sv1onw/Si5351_OLED_DFS_CW/si5351_amp_sm.jpg

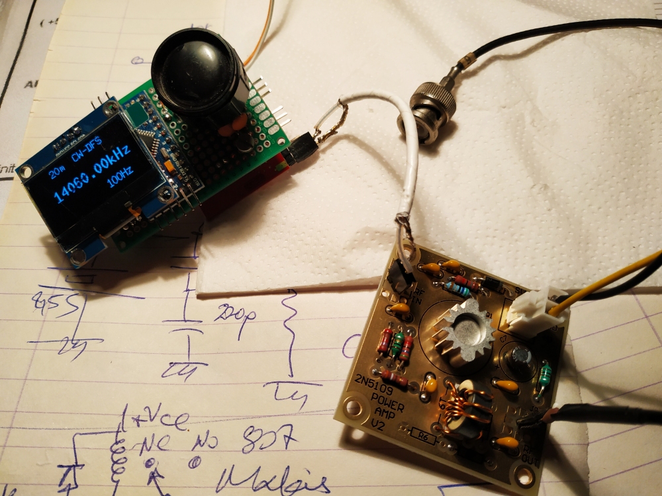
si5351_amp_sm.jpg
