sv1onw/Si5351_OLED_DFS_CW/2n5109 a1e22.png

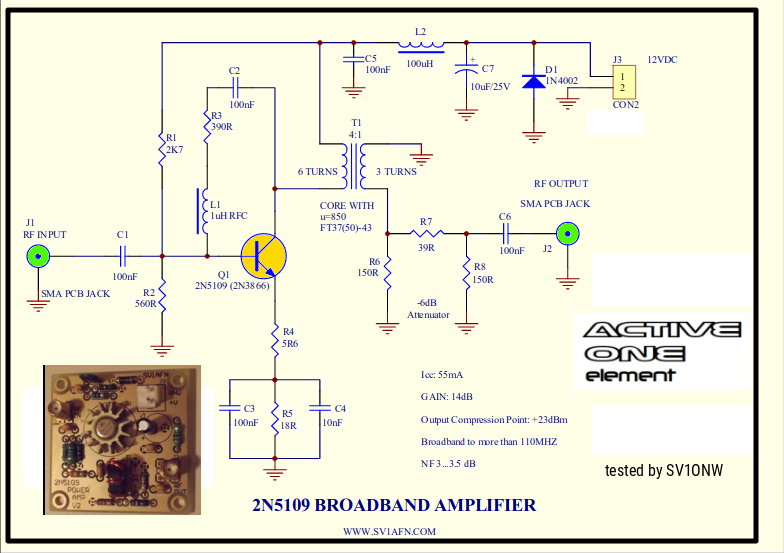
2n5109 a1e22.png
