sv1onw/Si5351_OLED_DFS_CW/20m lpf.png

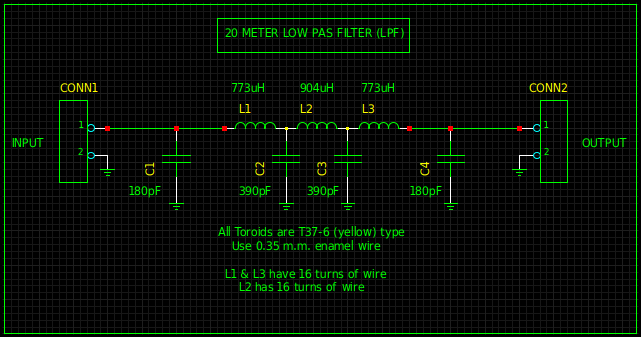
20m lpf.png
