sv1onw/Si5351_OLED_DFS_CW/CW KEYER1.JPG

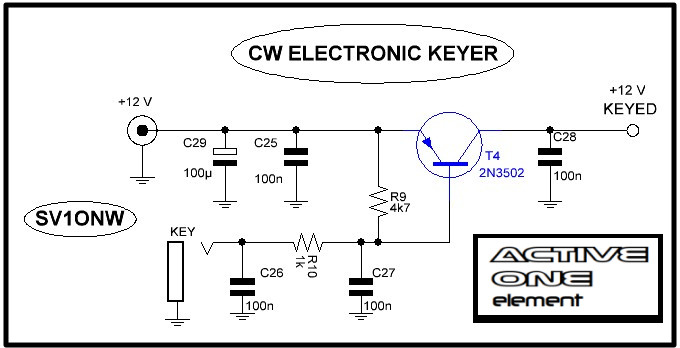
CW KEYER1.JPG
