sv1onw/Si5351_OLED_DFS_CW/CW_TX_20-DFS_v1.1.ino

// 20m CW_MONOBAND_TX  DFS  (Digital Frequency Synthesizer, aka PLL) 
// Initial PLL Code written by Antony Watts, M0IFA.
// Adaptation by SV1ONW to suit specific needs and incorporate Band frequency limits.
// 
// Band freq 14.000000 -14.10000 MHz = DFS frequency
// 
// CLK0 = L.O. DFS, CLK2 = Calibration Test Frequency 8.000000 MHz OPTION
  
#include "Oled.h"                                          // include header with predefined functions for U8g2 library (Library must be installed!)
#include <si5351.h>                                        // include library
#include "Rotary.h"                                        // include library

#define DT 2                                               // encoder connnections
#define CLK 3                                              // reverse pins 2 & 3 if wrong direction on rotary encoder!
#define SW 5                                               // the Digital pin where the Rotary Encoder's push button switch is connected
//
// Frequencies are written as xxYYYYYY00, where xx= Megacycles, YYYYYY= rest of frequency followed by two zeros. e,g, 3.2768 is written 327680000
#define CALIBRATION -4863                                  // frequency CALIBRATION, can be + or - , in my module is -57.63 Hz. Put your value here!

#define FREQMIN   1400000000                               // tune range 14.0-14.100 MHz , down limit
#define FREQMAX   1410000000                               // upper limit of 20 meter Band
//
//

Si5351 dfs;                                                // create dfs object
Rotary enc = Rotary(CLK, DT);                              // create encoder object

uint64_t freq = 1406000000;                                // initial frequency cHz, where DFS starts when powered on!
uint64_t freqStep = 10000;                                 // initial step cHz (100Hz), when powered on
uint64_t testFreq = 800000000;                             // test Frequency = 8.000000 MHz for Calibration purposes 

//

void setup() {
  pinMode(CLK, INPUT_PULLUP);                              // encoder input, with pull-up
  pinMode(DT, INPUT_PULLUP);                               // encoder input, with pull-up
  pinMode(SW, INPUT_PULLUP);                               // button  input, with pull-up

  oled.begin();                                            // begin OLED display

  dfs.init(SI5351_CRYSTAL_LOAD_8PF, 27000000, CALIBRATION);// set xtal capacitance, CRYSTAL FREQUENCY = 27MHz. CALIBRATION value is defined above.
                                                           // initial xtal frequency of 27MHz is defined in "si5351.h" header file! 
                                                           // crystal load is 8pF for SV1AFN's Si5351a board!
  dfs.drive_strength(SI5351_CLK0, SI5351_DRIVE_8MA);       // output drive 2 or 4 or 6 or 8ma. 8ma is aprox. +10dBm! 
//
  dfs.drive_strength(SI5351_CLK2, SI5351_DRIVE_2MA);       // output drive 2 or 4 or 6 or 8ma. 8ma is aprox. +10dBm!
// ONE OUTPUT ONLY plus Calibration optional

  dfs.output_enable(SI5351_CLK0, 1);                       // enable CLK0 
//
  dfs.output_enable(SI5351_CLK2, 1);                       // enable CLK2

  freqSet(freq , 0);                                       // output frequency CLK0, 14.060000 MHz 
//
//freqSet(testFreq, 2);                                    // output frequency CLK2, 8.000000 MHz Test Frequency for manual Calibration, you must enable it first (see below)!
  
//

  dispUpdate();                                            // display
}

// LOOP
void loop() {
//
  unsigned char result;                                    // encoder result

  if (digitalRead(SW) == LOW) {                            // enc button push
//
    while (!digitalRead(SW));                              // wait release
//
// 
//   
//     
//     
//     
//
    if (freqStep == 1000) freqStep = 1000000;              // update step i.e. 1000000 = 10kHz
    else freqStep = freqStep / 10;                         // step down
    dispUpdate();                                          // display
  }

  result = enc.process();                                  // read encoder
  if (result == DIR_CW)  {                                 // freq up
    freq += freqStep;
    if (freq >=FREQMAX)  {                                 // check the upper limit 14.100 MHz
        freq  =FREQMAX;
    }  
    freqSet(freq, 0);                                      // update CLK0/freq 
    dispUpdate();
  }
  if (result == DIR_CCW) {                                 // freq down
    freq -= freqStep;
    if (freq <=FREQMIN)  {                                 // check the lower limit 14.000 MHz
        freq  =FREQMIN;
    }  
    freqSet(freq, 0);                                      // update CLK0/freq
    dispUpdate();
  }
}

void freqSet(uint64_t f, byte n) {                         // output frequency, 0/DFS actual freq, 1/test Frequency
  switch (n) {
    case 0:
      dfs.set_freq(f, SI5351_CLK0);                        // DFS VFO  actual 14.000 - 14.100 MHz
// 
//
case 1:
      dfs.set_freq(f, SI5351_CLK2);                        // test freq
  }
}

void dispUpdate() {                                        // OLED loop
  oled.firstPage();
  do {
    dispMsg(25, 0, "20m  CW-DFS");                         // display title
    dispFreq(15, 25, freq / 100, 0, 2);                    // display frequency, in kHz/Hz
// 
//
//
//
    dispStep(80, 50, freqStep / 100);                      // display step
  } while ( oled.nextPage() );
}
