sv1onw/Si5351_OLED_DFS_CW/(commit log)

2019-03-26 Add files via upload
    Added 20m LPF circuit
2019-03-28 Update CW_TX_20-DFS_v1.1.ino
    Corrected some comments
    [CW_TX_20-DFS_v1.1.ino]
